DamianWaclawiak/Projekt_EEA/Wzmacniacz Audio klasy A/KiCad/Projekt_PCB_WzmacniaczaTen/Projekt_PCB_Wzmacniacza.kicad_pcb

## KiCad design Wzmacniacz Audio klasy A/KiCad/Projekt_PCB_WzmacniaczaTen/Projekt_PCB_Wzmacniacza.kicad_pcb (2021-12-14)

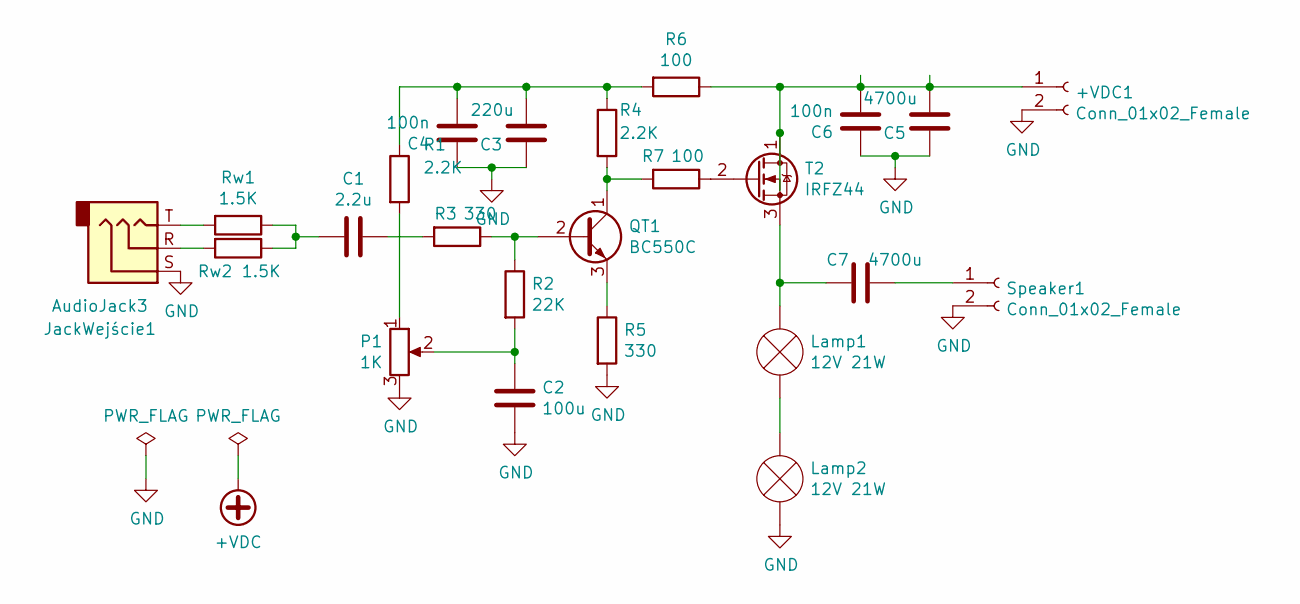
[picture p16: schematic Projekt_PCB_Wzmacniacza.sch]

Parts:
+VDC1: Conn_01x02_Female; PinSocket_1x02_P1.00mm_Vertical
C1: 2.2u; C_Disc_D3.0mm_W1.6mm_P2.50mm
C2: 100u; C_Disc_D3.0mm_W1.6mm_P2.50mm
C3: 220u; C_Disc_D3.0mm_W1.6mm_P2.50mm
C4, C6: 100n; C_Disc_D3.0mm_W1.6mm_P2.50mm
C5, C7: 4700u; C_Disc_D3.0mm_W1.6mm_P2.50mm
JackWejście1: AudioJack3; Jack_3.5mm_CUI_SJ-3523-SMT_Horizontal
Lamp1, Lamp2: 12V 21W; PinSocket_1x02_P2.00mm_Vertical
P1: 1K; Potentiometer_Alps_RK097_Single_Horizontal
QT1: BC550C; TerminalBlock_bornier-3_P5.08mm
R1, R4: 2.2K; R_Axial_DIN0204_L3.6mm_D1.6mm_P5.08mm_Horizontal
R2: 22K; R_Axial_DIN0204_L3.6mm_D1.6mm_P5.08mm_Horizontal
R3, R5: 330; R_Axial_DIN0204_L3.6mm_D1.6mm_P5.08mm_Horizontal
R6, R7: 100; R_Axial_DIN0204_L3.6mm_D1.6mm_P5.08mm_Horizontal
Rw1, Rw2: 1.5K; R_Axial_DIN0204_L3.6mm_D1.6mm_P5.08mm_Horizontal
Speaker1: Conn_01x02_Female; PinSocket_1x02_P1.00mm_Vertical
T2: IRFZ44; TerminalBlock_bornier-3_P5.08mm

Connections:
GND: +VDC1.2, C2.2, C3.1, C4.1, C5.1, C6.1, JackWejście1.S, Lamp2.1 (-), P1.3, R5.2, Speaker1.2
unnamed: +VDC1.1, C5.2, C6.2, R6.1, T2.1 (D)
unnamed: C1.1, R3.2
unnamed: C1.2, Rw1.1, Rw2.1
unnamed: C2.1, P1.2, R2.2
unnamed: C3.2, C4.2, R1.1, R4.1, R6.2
unnamed: C7.1, Speaker1.1
unnamed: C7.2, Lamp1.2 (+), T2.3 (S)
unnamed: JackWejście1.R, Rw2.2
unnamed: JackWejście1.T, Rw1.2
unnamed: Lamp1.1 (-), Lamp2.2 (+)
unnamed: P1.1, R1.2
unnamed: QT1.1 (C), R4.2, R7.2
unnamed: QT1.2 (B), R2.1, R3.1
unnamed: QT1.3 (E), R5.1
unnamed: R7.1, T2.2 (G)

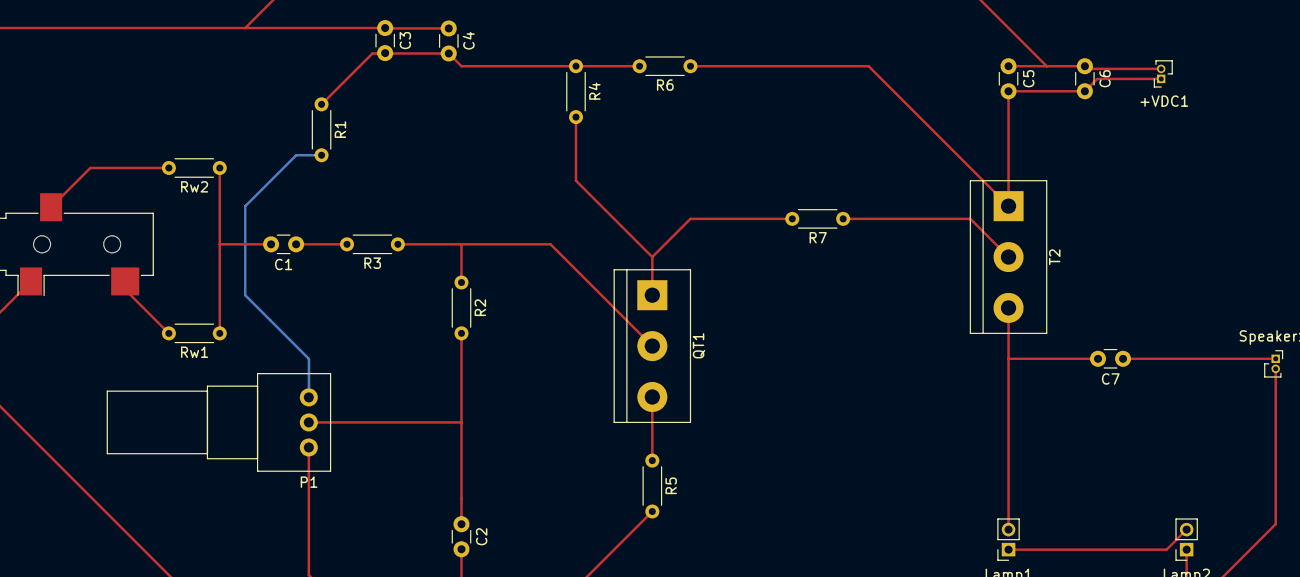
[picture p17: board Projekt_PCB_Wzmacniacza.kicad_pcb from above]

Board: 2 copper layers, 24 parts (0 on the bottom side), 16 nets.
